MAATHES-THILAK-K/Stellar_Vision_V1/README.md

# Stellar Vision V1





**An Assistive Braille Input Device with AI Integration**

Stellar Vision V1 is an advanced assistive technology device designed for visually impaired users, featuring a 14-key Braille input system, AI-powered functionalities, and comprehensive connectivity options.

## ✨ Key Features

- **🟠 Braille Input System**: 14-key input with 6-dot Braille pattern recognition
- **🤖 AI Integration**: Query Gemini AI directly from the device
- **🔊 Multi-Modal Feedback**: Audio feedback, text-to-speech, and vibration alerts
- **📁 File Management**: SD card storage with wireless upload capabilities
- **🔗 Connectivity**: HID keyboard output, BLE notifications, WiFi for OTA updates
- **🆘 Safety Features**: SOS emergency alert system via SMS
- **🎯 Accessibility**: One-hand gesture mode via MPU6050 accelerometer

## 🛠 Technical Specifications

| Component | Specification |
|---|---|
| **MCU** | ESP32C6 (dual-core, 160MHz) |
| **GPIO Expander** | PCF8575 (I2C address 0x20) |
| **HID Interface** | DigiSpark ATtiny85 (I2C address 0x23) |
| **IMU** | MPU6050 (I2C address 0x68) |
| **Audio** | MAX98357A I2S amplifier |
| **Storage** | SD card (SPI, FAT32 format) |
| **Connectivity** | BLE (ChronosESP32), WiFi |

## 📦 Repository Structure

```
Stellar_Vision_V1/
├── 3D Models/
│   ├── F3D/
│   │   └── Stellar Vision V2 v10.f3d
│   ├── Images/
│   │   ├── BODY.png
│   │   ├── ISOMETRIC.png
│   │   ├── LID_FLIPPED.png
│   │   └── LID_TOPVIEW.png
│   └── Printables/
│       ├── BODY.stl
│       └── LID.stl
│
├── Circuits/
│   ├── Connections.md
│   ├── Stellar Vision V1 bom.html
│   └── Stellar Vision V1 pdf.pdf
│
├── Firmware/
│   ├── releases/
│   │   └── firmwarevx.x/
│   │       ├── firmware.bin
│   │       └── firmware.json
│   └── latest.json
│
├── Manual Sheet/
│   ├── Stellar Vision V1 - MANUAL.pdf
│   └── Stellar_Vision_V1-MANUAL.md
│
├── SD_CARD Files/
│   ├── Alphabets/
│   ├── AudioFiles/
│   ├── TACTI_VISION_WAV/
│   └── Expansion_Guide.md
│
├── src/
│   ├── Latest_Firmware/
│   │   ├── Digispark/
│   │   │   ├── Flash.md
│   │   │   └── Stellar_Vision_Digispark.ino
│   │   └── ESP32C6/
│   │       ├── firmware.ino
│   │       └── partitions.csv
│   └── configuration.md
│
├── Build_Instruction.md
├── Upcoming_Updates.md
├── README.md
└── LICENCE.txt

```

## 🚀 Getting Started

### Prerequisites
- SD card formatted as FAT32
- Arduino IDE or compatible ESP32 development environment
- Required libraries: PCF8575, ArduinoJson, WiFi, HTTPClient

### Installation
1. Clone this repository
2. Insert SD card with required folder structure
3. Upload firmware to ESP32C6
4. Configure API keys for Gemini AI, VoiceRSS, OCR.space, and Twilio

### Basic Usage
- **Power On**: Device boots into NORMAL MODE
- **Typing**: Short press SELECT to enter PERKINS MODE for Braille input
- **Mode Selection**: Long press SELECT to access MODE OPTIONS
- **Emergency**: Hold either SPACE button for 1.5s to trigger SOS alert

## 📚 Documentation

- **[Full User Manual](Manual%20Sheet/Stellar_Vision_V1-MANUAL.md)** - Comprehensive usage instructions
- **[Firmware Releases](Firmware/releases/firmware_v2.1)** - Latest firmware and updates
- **[Manual PDF](Manual%20Sheet/Stellar%20Vision%20V1%20-%20MANUAL.pdf)** - Printable manual version

## 🔧 Operating Modes

| Mode | Purpose | Key Feature |
|---|---|---|
| **PERKINS MODE** | Braille typing | Real-time HID keyboard output |
| **GEMINI AI** | AI queries | Google Gemini AI integration |
| **NOTE-MAKER** | Note taking | SD card storage with auto-correction |
| **B-DRIVE** | OCR processing | Text extraction from images/PDFs |
| **SD UPLOAD** | File management | Wireless web interface for file transfer |
| **AUDIO PLAYER** | Media playback | WAV file support with navigation controls |

## 🆘 Emergency Features

The device includes a comprehensive SOS system:
- **Activation**: Hold either SPACE button for 1.5 seconds
- **Notification**: Sends SMS via Twilio with device status and uptime
- **Safety**: 30-second cooldown between alerts to prevent accidental triggers

## 🔄 Firmware Updates

- **OTA Updates**: Available via SYSTEM UPDATE mode
- **Manual Updates**: Flash through Arduino IDE
- **Version Check**: Automatic checking against `Firmware/latest.json`

## 📄 License

This project is licensed under the **PolyForm Noncommercial License 1.0.0** - see the [LICENCE.txt](LICENCE.txt) file for details.

**Required Notice**: Copyright © 2025 MAATHES THILAK K (https://github.com/MAATHES-THILAK-K)

## 👨‍💻 Author

**Maathes Thilak K**  
Bachelor of Engineering – ECE  
Madras Institute of Technology (MIT), Anna University, Chennai

**Development Philosophy**:  
*"Vibe Coding — Leveraging AI as a collaborative tool to accelerate innovation and create meaningful accessibility solutions."*

## 🤝 Contributing

While this is a personal project, feedback and suggestions are welcome. Please ensure compliance with the noncommercial license terms.

---

**Stellar Vision V1 – Making Technology Accessible**  
*Firmware Version: 2.1 | Last Updated: November 2025*
