MAATHES-THILAK-K/Stellar_Vision_V1/3D Models/Images/BODY.png

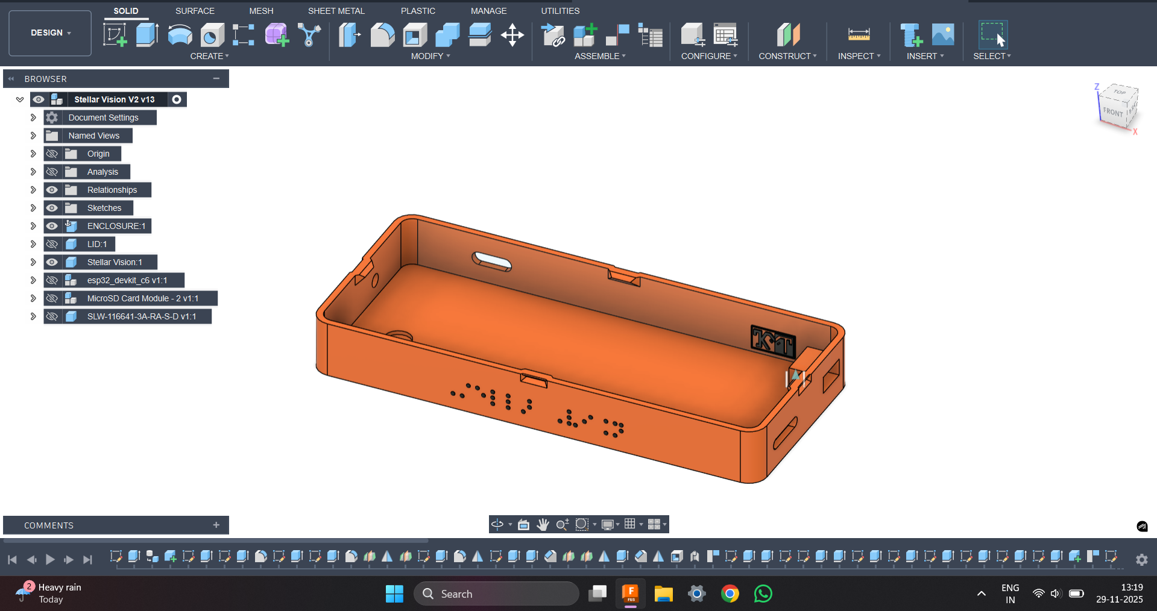
3D Models/Images/BODY.png
