MAATHES-THILAK-K/Stellar_Vision_V1/3D Models/Images/ISOMETRIC.png

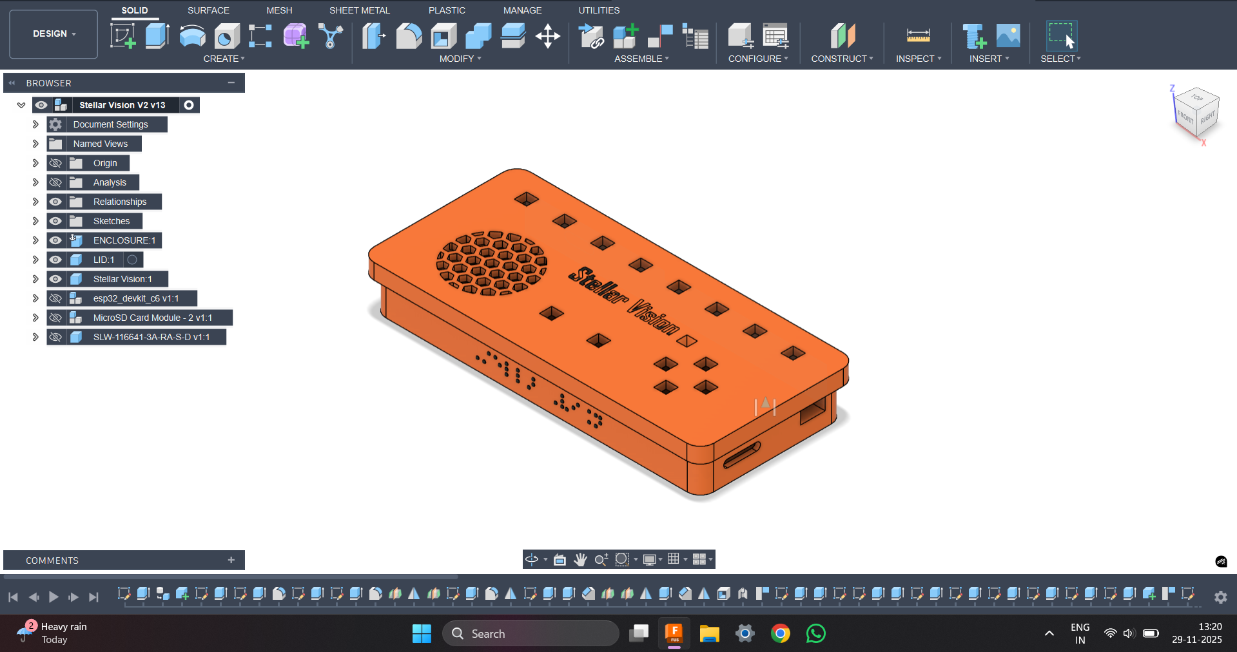
3D Models/Images/ISOMETRIC.png
