MAATHES-THILAK-K/Stellar_Vision_V1/3D Models/Images/LID_TOPVIEW.png

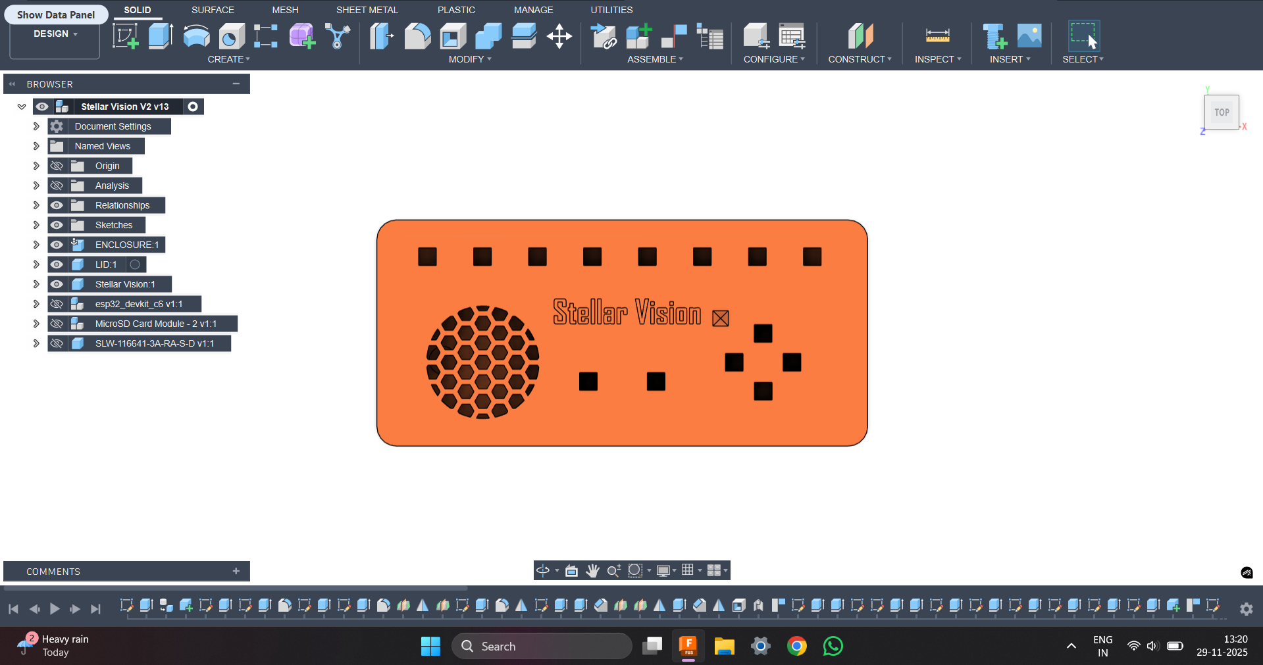
3D Models/Images/LID_TOPVIEW.png
