MAATHES-THILAK-K/Stellar_Vision_V1/Circuits/Stellar Vision V1 pdf.pdf

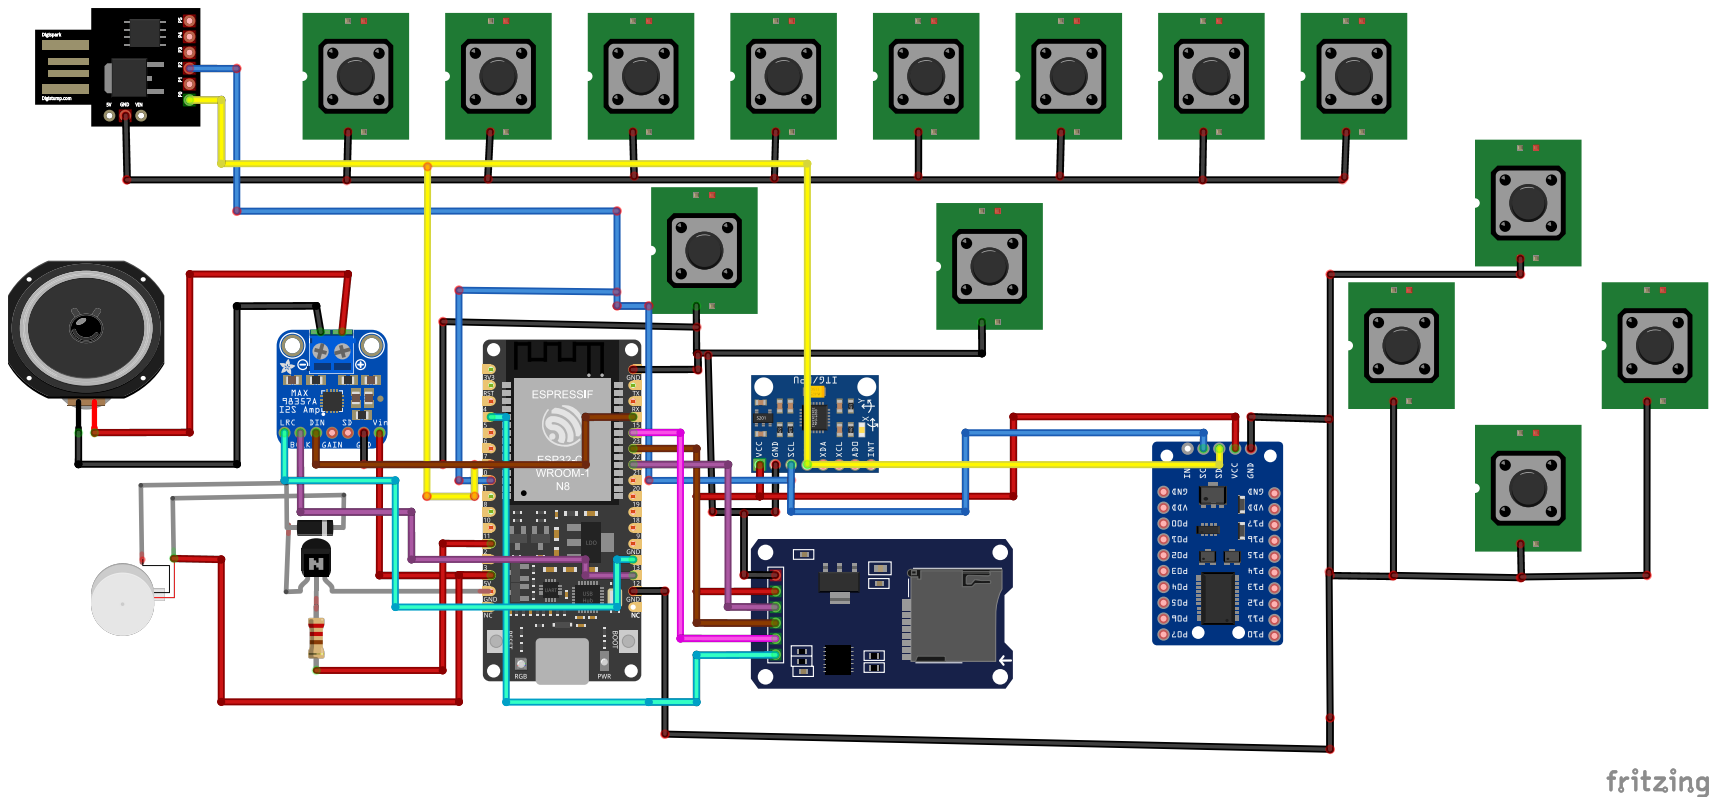
[picture p4: page 1]
