MAATHES-THILAK-K/Stellar_Vision_V1/(notices)

Notices in the files:
README.md:
License: PolyForm Noncommercial 1.0.0
